ultimaterobotics/surface-emg-eeg/SurfaceEEG_E_V1.3.brd

## EAGLE design SurfaceEEG_E_V1.3.brd (2016-12-27)

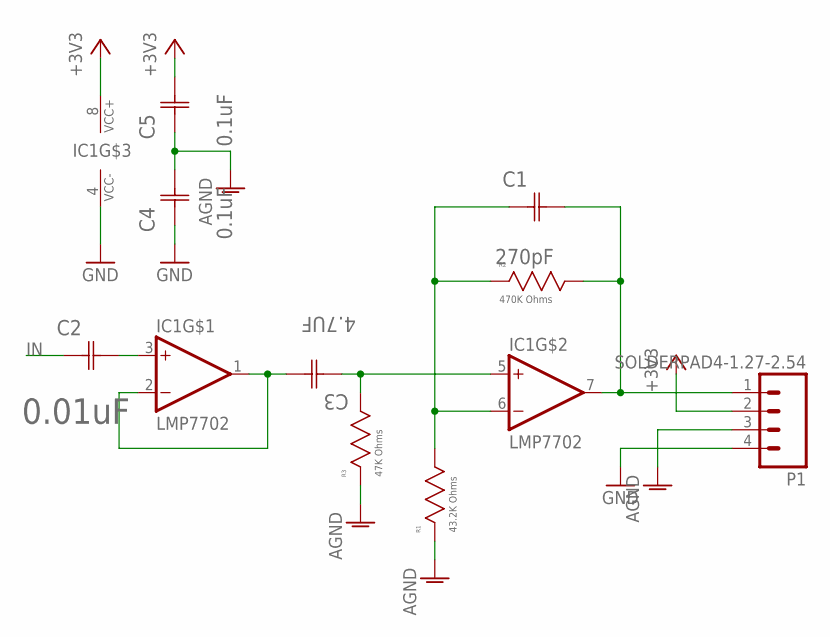
[picture p1: schematic SurfaceEEG_E_V1.3.sch]

Parts:
C1: 270pF; CAPC1608X90N
C2: 0.01uF; CAPC1005X60N
C3: 4.7UF; CAPC1608X90N
C4, C5: 0.1uF; CAPC1005X60N
IC1: LMP7702; VSSOP8
P1: SOLDERPAD4-1.27-2.54; SMD1,27-2,54
R1: 43.2K Ohms; RESC1608X60N
R2: 470K Ohms; RESC1608X60N
R3: 47K Ohms; RESC1608X60N

Connections:
+3V3: C5.1 (C2), IC1.8 (VCC+), P1.2
AGND: C4.1 (C2), C5.2 (C1), P1.3, R1.2 (R2), R3.2 (R2)
GND: C4.2 (C1), IC1.4 (VCC-), P1.4
IN: C2.1 (C1)
unnamed: C2.2 (C2), IC1.3 (IN+)
unnamed: C1.1 (C1), IC1.6 (IN-), R1.1 (R1), R2.2 (R2)
unnamed: C3.1 (C1), IC1.5 (IN+), R3.1 (R1)
unnamed: C1.2 (C2), IC1.7 (OUT), P1.1, R2.1 (R1)
SHIELD: C3.2 (C2), IC1.1 (OUT), IC1.2 (IN-)

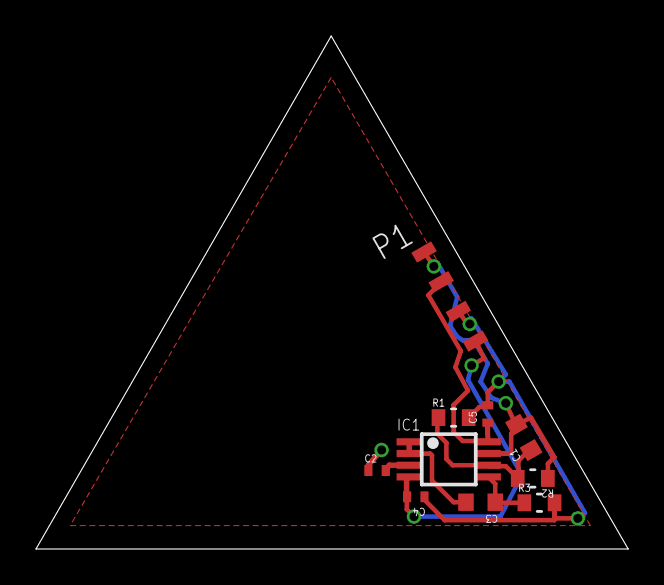
[picture p2: board SurfaceEEG_E_V1.3.brd from above]

Board: 2 copper layers, 32.9 x 28.5 mm, 10 parts (0 on the bottom side), 8 nets.
