ultimaterobotics/surface-emg-eeg/SurfaceEEG_V1.4.brd

## EAGLE design SurfaceEEG_V1.4.brd (2016-12-24)

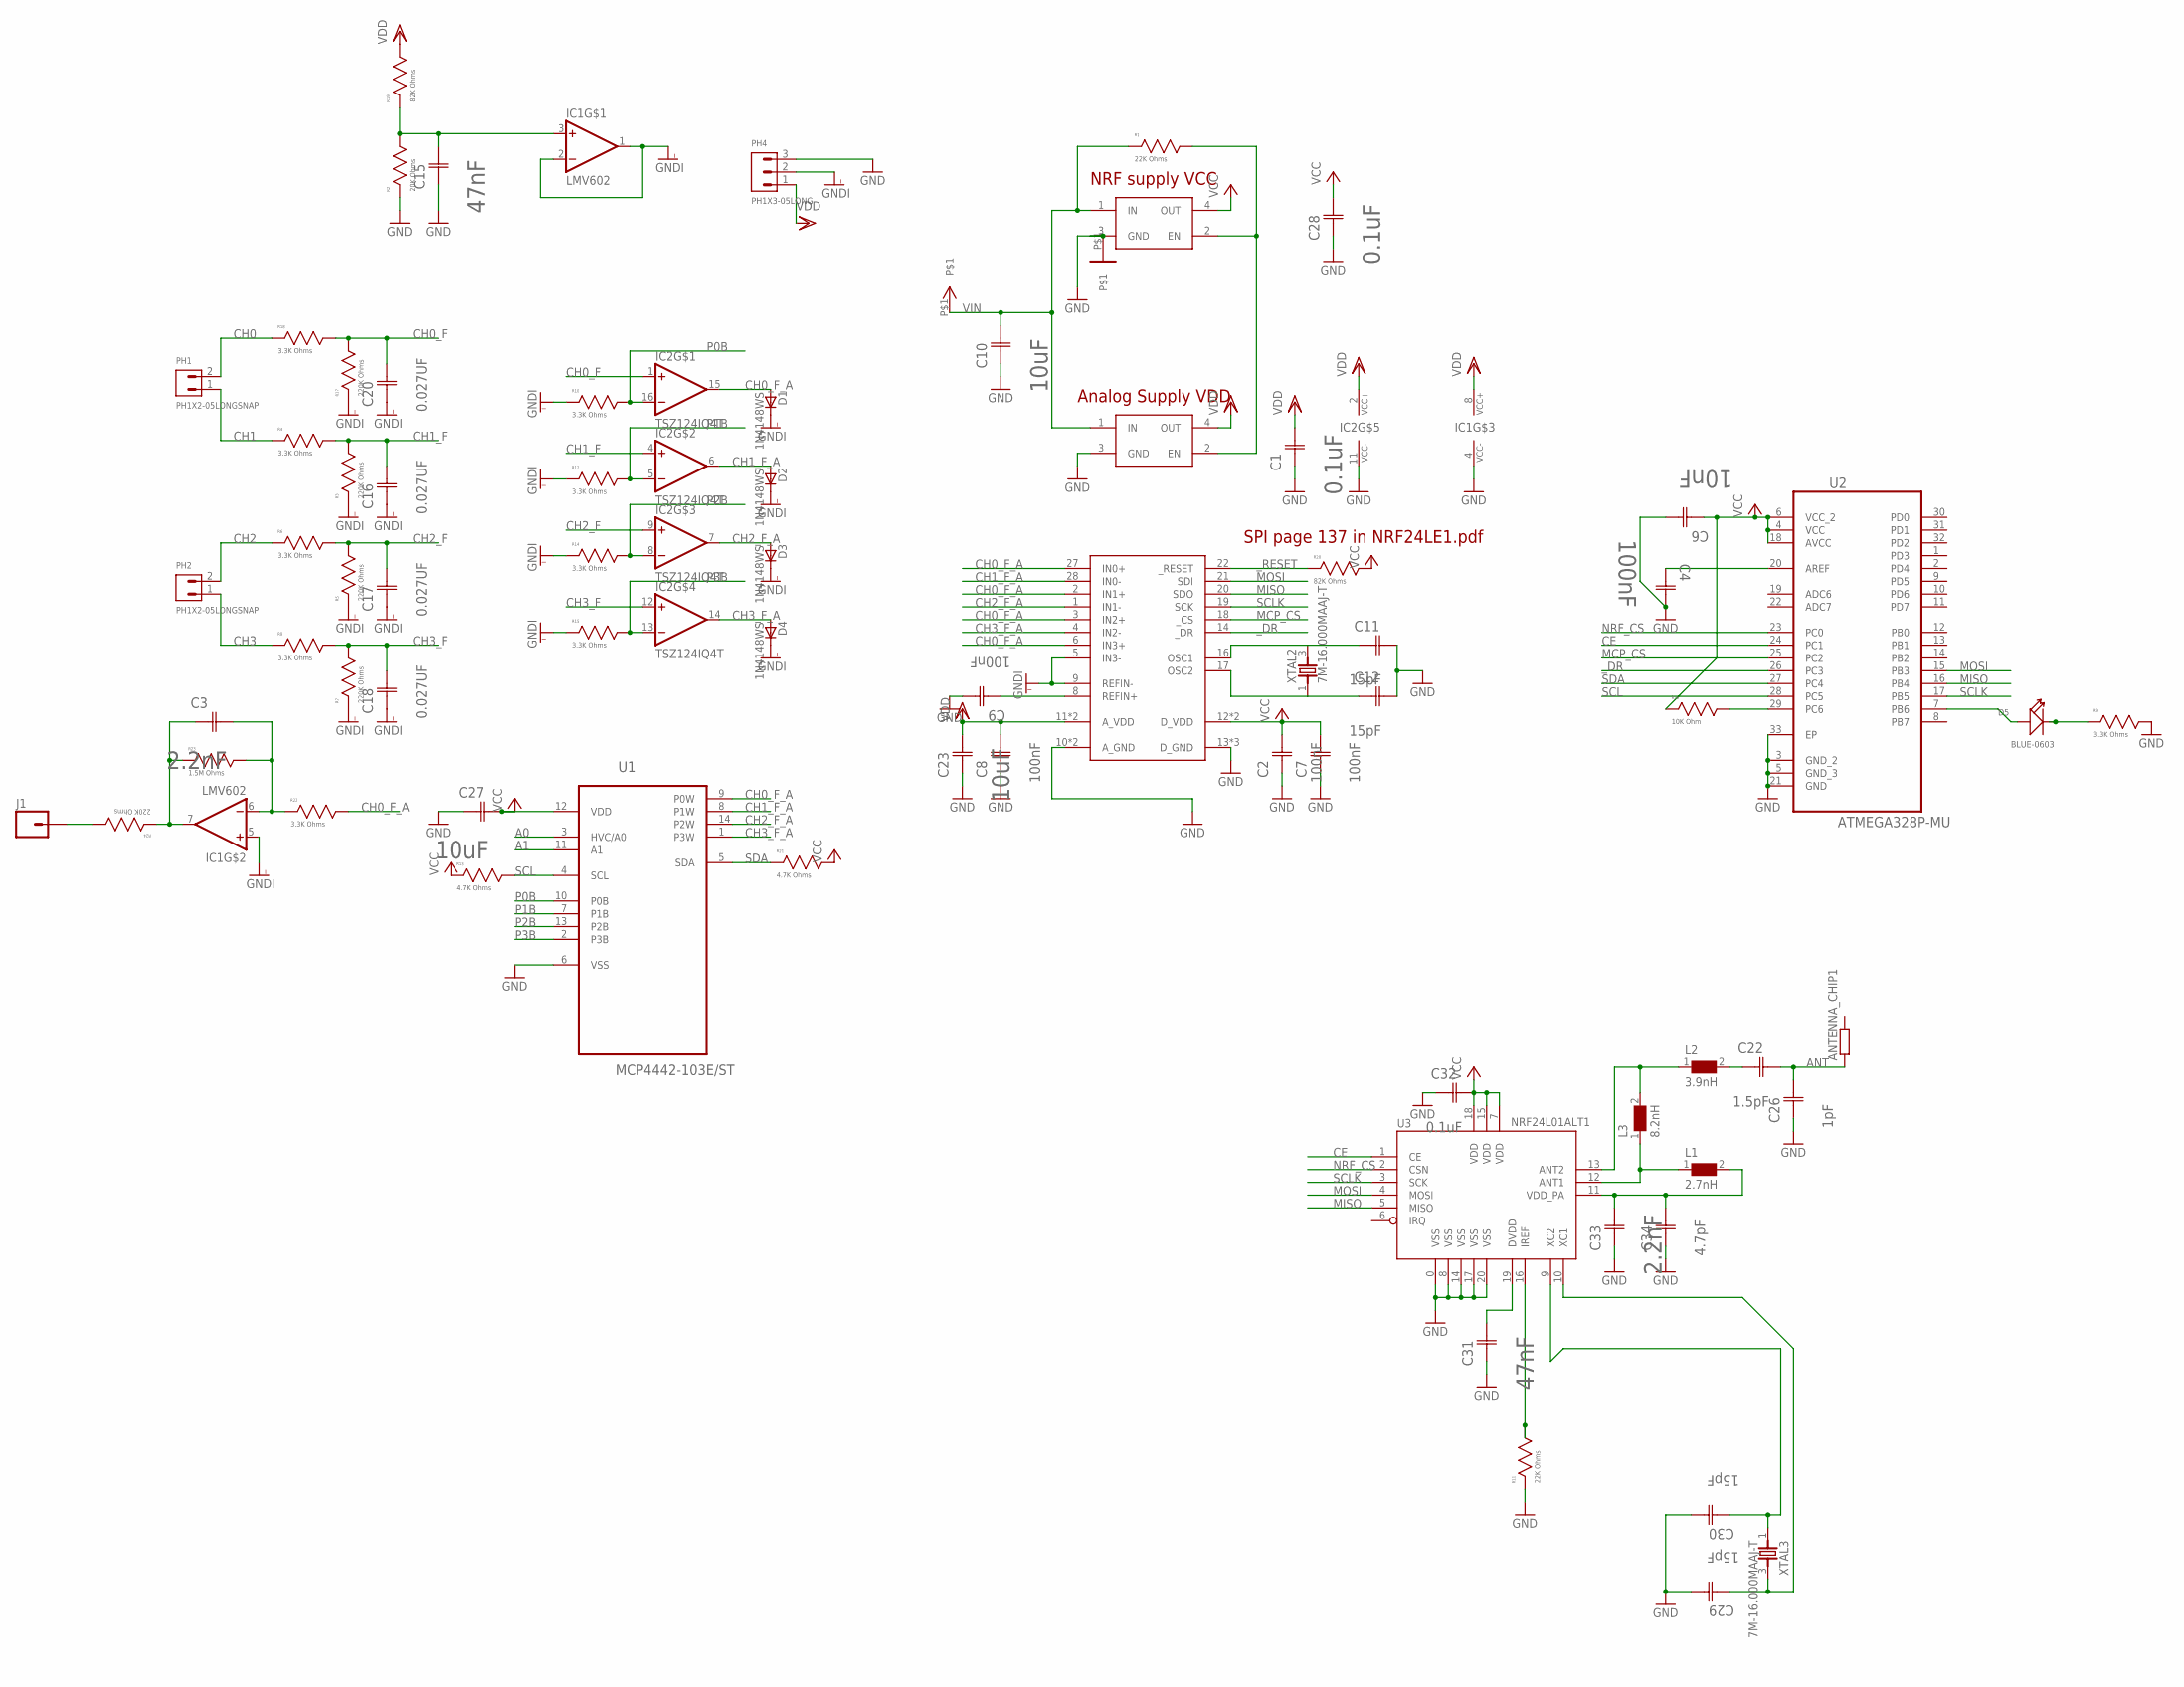
[picture p3: schematic SurfaceEEG_V1.4.sch]

Parts:
ANTENNA_CHIP1: R0805
C1, C28: 0.1uF; CAPC1608X85N
C2, C7, C8, C9: 100nF; CAPC1608X90N
C3, C33: 2.2nF; CAPC1005X60N
C4: 100nF; CAPC1608X85N
C6: 10nF; CAPC1608X85N
C10, C23, C27: 10uF; CAPC1608X85N
C11, C12, C29, C30: 15pF; CAPC1005X60N
C15, C31: 47nF; CAPC1608X85N
C16, C17, C18, C20: 0.027UF; CAPC1608X90N
C22: 1.5pF; CAPC1005X60N
C26: 1pF; CAPC1005X60N
C32: 0.1uF; CAPC1005X60N
C34: 4.7pF; CAPC1005X60N
D1, D2, D3, D4: 1N4148WS; SOD323F
D5: BLUE-0603; LED-0603
IC1: LMV602; VSSOP8
IC2: TSZ124IQ4T; QFN16
J1: M01SMD-4.5X1.5; PAD-1.5X4.5
L1: 2.7nH; WE-KI_0402A
L2: 3.9nH; WE-KI_0402A
L3: 8.2nH; WE-KI_0402A
PH1, PH2: PH1X2-05LONGSNAP; PHLS005-1-2
PH4: PH1X3-05LONG; PHL005-1-3
R1, R11: 22K Ohms; RESC1608X60N
R2: 20K Ohms; RESC1608X60N
R3, R5, R7, R17, R24: 220K Ohms; RESC1608X60N
R4, R6, R8, R9, R10, R12, R14, R15, R18, R22: 3.3K Ohms; RESC1608X60N
R13, R21: 4.7K Ohms; RESC1005X40N
R16: 10K Ohm; RESC1608X60N
R19, R20: 82K Ohms; RESC1608X60N
R23: 1.5M Ohms; RESC1608X60N
U1: MCP4442-103E/ST; SOP65P640X120-14N
U2: ATMEGA328P-MU; QFN50P500X500X100-33N
U3: NRF24L01ALT1; QFN20_ALT1
U$1, U$2: NCP103; UDFN4-1*1
U$3: MCP3912; QFN28
U$4: VCC; VCC-PAD
U$5: GND; GND-PAD
XTAL2, XTAL3: 7M-16.000MAAJ-T; TXC_7M-16.000MAAJ-T

Connections:
A0: U1.3 (HVC/A0)
A1: U1.11 (A1)
ANT: ANTENNA_CHIP1.1, C22.1 (C2), C26.1 (C2)
ANT1: L1.1, L3.1, U3.12 (ANT1)
ANT2: L2.1, L3.2, U3.13 (ANT2)
CE: U2.24 (PC1), U3.1 (CE)
CH0: PH1.2, R18.2 (R2)
CH0_F: C20.2 (C2), IC2.1 (IN+), R17.1 (R1), R18.1 (R1)
CH0_F_A: D1.A, IC2.15 (OUT), R22.1 (R1), U1.9 (P0W), U$3.2 (IN1+), U$3.3 (IN2+), U$3.6 (IN3+), U$3.27 (IN0+)
CH1: PH1.1, R4.2 (R2)
CH1_F: C16.2 (C2), IC2.4 (IN+), R3.1 (R1), R4.1 (R1)
CH1_F_A: D2.A, IC2.6 (OUT), U1.8 (P1W), U$3.28 (IN0-)
CH2: PH2.2, R6.2 (R2)
CH2_F: C17.2 (C2), IC2.9 (IN+), R5.1 (R1), R6.1 (R1)
CH2_F_A: D3.A, IC2.7 (OUT), U1.14 (P2W), U$3.1 (IN1-)
CH3: PH2.1, R8.2 (R2)
CH3_F: C18.2 (C2), IC2.12 (IN+), R7.1 (R1), R8.1 (R1)
CH3_F_A: D4.A, IC2.14 (OUT), U1.1 (P3W), U$3.4 (IN2-)
GND: C1.1 (C1), C2.1 (C1), C4.2 (C2), C6.2 (C2), C7.1 (C1), C8.1 (C1), C9.2 (C2), C10.1 (C1), C11.1 (C2), C12.1 (C2), C15.1 (C1), C23.1 (C1), C26.2 (C1), C27.1 (C1), C28.1 (C1), C29.1 (C2), C30.1 (C2), C31.1 (C1), C32.2 (C1), C33.1 (C1), C34.2 (C1), IC1.4 (VCC-), IC2.11 (VCC-), PH4.3, R2.2 (R2), R9.1 (R1), R11.2 (R2), U1.6 (VSS), U2.3 (GND_2), U2.5 (GND_3), U2.21 (GND), U2.33 (EP), U3.0 (VSS), U3.8 (VSS), U3.14 (VSS), U3.17 (VSS), U3.20 (VSS), U$1.3 (GND), U$2.3 (GND), U$3.10 (A_GND), U$3.13 (D_GND), U$3.15 (D_GND), U$3.23 (D_GND), U$3.26 (A_GND), U$5.P$1
GNDI: C16.1 (C1), C17.1 (C1), C18.1 (C1), C20.1 (C1), D1.C, D2.C, D3.C, D4.C, IC1.1 (OUT), IC1.2 (IN-), IC1.5 (IN+), PH4.2, R3.2 (R2), R5.2 (R2), R7.2 (R2), R10.2 (R2), R12.2 (R2), R14.2 (R2), R15.2 (R2), R17.2 (R2), U$3.5 (IN3-), U$3.9 (REFIN-)
MCP_CS: U2.25 (PC2), U$3.18 (_CS)
MISO: U2.16 (PB4), U3.5 (MISO), U$3.20 (SDO)
MOSI: U2.15 (PB3), U3.4 (MOSI), U$3.21 (SDI)
unnamed: D5.+, U2.7 (PB6)
unnamed: D5.-, R9.2 (R2)
unnamed: C3.2 (C2), IC1.6 (IN-), R22.2 (R2), R23.1 (R1)
unnamed: R1.1 (R1), U$1.2 (EN), U$2.2 (EN)
unnamed: C3.1 (C1), IC1.7 (OUT), R23.2 (R2), R24.2 (R2)
unnamed: C4.1 (C1), U2.20 (AREF)
unnamed: C30.2 (C1), U3.9 (XC2), XTAL3.1
unnamed: C29.2 (C1), U3.10 (XC1), XTAL3.3
unnamed: J1.P$1, R24.1 (R1)
unnamed: C9.1 (C1), U$3.8 (REFIN+)
unnamed: C22.2 (C1), L2.2
unnamed: C11.2 (C1), U$3.16 (OSC1), XTAL2.3
unnamed: C12.2 (C1), U$3.17 (OSC2), XTAL2.1
unnamed: C33.2 (C2), C34.1 (C2), L1.2, U3.11 (VDD_PA)
unnamed: C15.2 (C2), IC1.3 (IN+), R2.1 (R1), R19.2 (R2)
unnamed: R11.1 (R1), U3.16 (IREF)
unnamed: C31.2 (C2), U3.19 (DVDD)
NRF_CS: U2.23 (PC0), U3.2 (CSN)
P0B: IC2.16 (IN-), R10.1 (R1), U1.10 (P0B)
P1B: IC2.5 (IN-), R12.1 (R1), U1.7 (P1B)
P2B: IC2.8 (IN-), R14.1 (R1), U1.13 (P2B)
P3B: IC2.13 (IN-), R15.1 (R1), U1.2 (P3B)
RESET: R16.1 (R1), U2.29 (PC6)
SCL: R13.1 (R1), U1.4 (SCL), U2.28 (PC5)
SCLK: U2.17 (PB5), U3.3 (SCK), U$3.19 (SCK)
SDA: R21.2 (R2), U1.5 (SDA), U2.27 (PC4)
VCC: C2.2 (C2), C6.1 (C1), C7.2 (C2), C27.2 (C2), C28.2 (C2), C32.1 (C2), R13.2 (R2), R16.2 (R2), R20.1 (R1), R21.1 (R1), U1.12 (VDD), U2.4 (VCC), U2.6 (VCC_2), U2.18 (AVCC), U3.7 (VDD), U3.15 (VDD), U3.18 (VDD), U$1.4 (OUT), U$3.12 (D_VDD), U$3.24 (D_VDD)
VDD: C1.2 (C2), C8.2 (C2), C23.2 (C2), IC1.8 (VCC+), IC2.2 (VCC+), PH4.1, R19.1 (R1), U$2.4 (OUT), U$3.11 (A_VDD), U$3.25 (A_VDD)
VIN: C10.2 (C2), R1.2 (R2), U$1.1 (IN), U$2.1 (IN), U$4.P$1
_DR: U2.26 (PC3), U$3.14 (_DR)
_RESET: R20.2 (R2), U$3.22 (_RESET)

Notes on the sheet:
SPI page 137 in NRF24LE1.pdf
NRF supply VCC
Analog Supply VDD

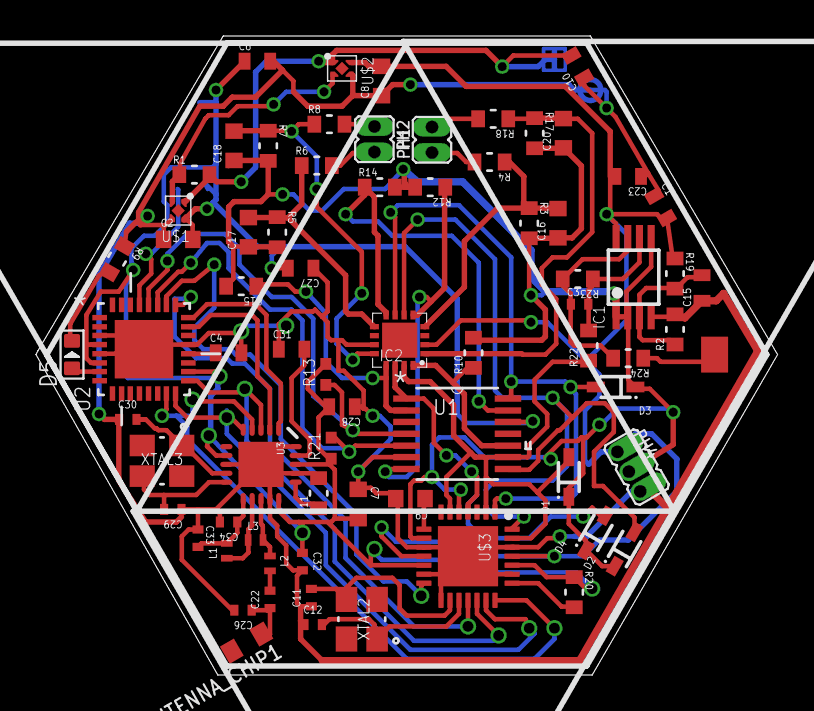
[picture p4: board SurfaceEEG_V1.4.brd from above]

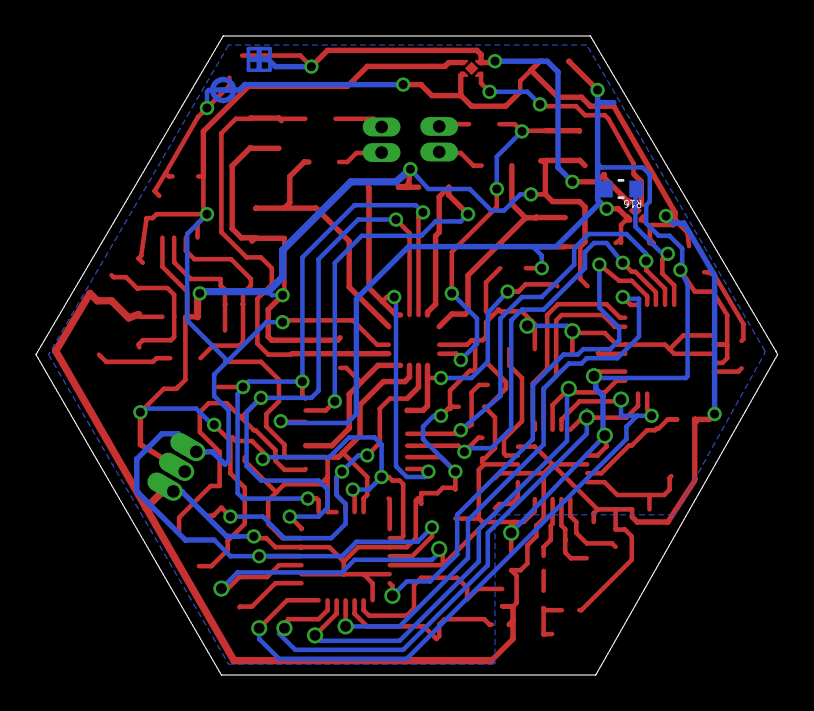
[picture p5: board SurfaceEEG_V1.4.brd from below]

Board: 2 copper layers, 41.2 x 35.5 mm, 76 parts (3 on the bottom side), 52 nets.
