ultimaterobotics/surface-emg-eeg/SurfaceEEG_Central_V1.0.brd

## EAGLE design SurfaceEEG_Central_V1.0.brd (2016-12-12)

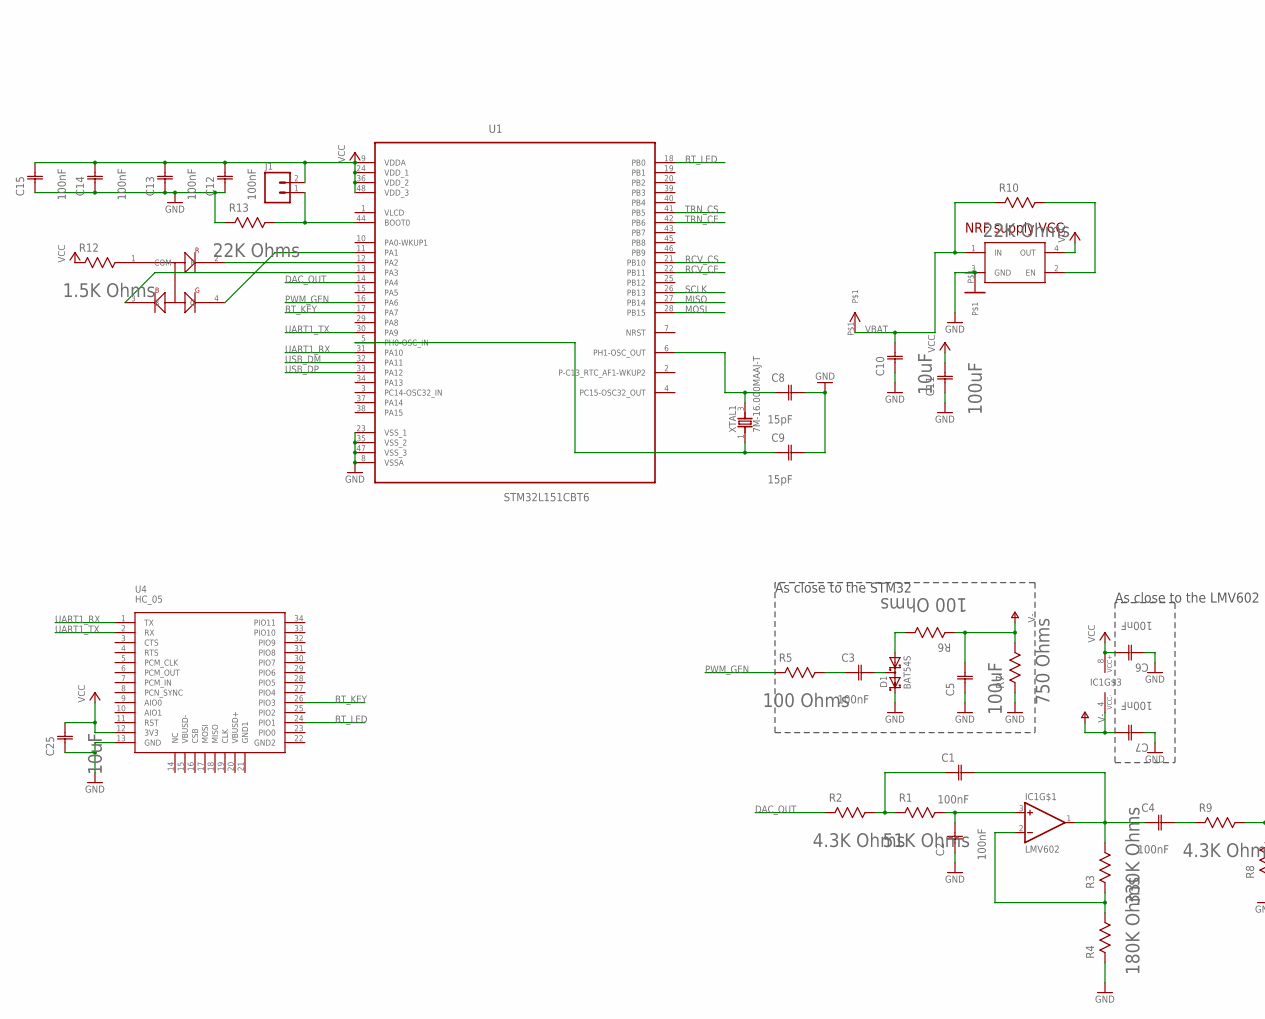
[picture p6: schematic SurfaceEEG_Central_V1.0.sch, part in row 1, column 1]

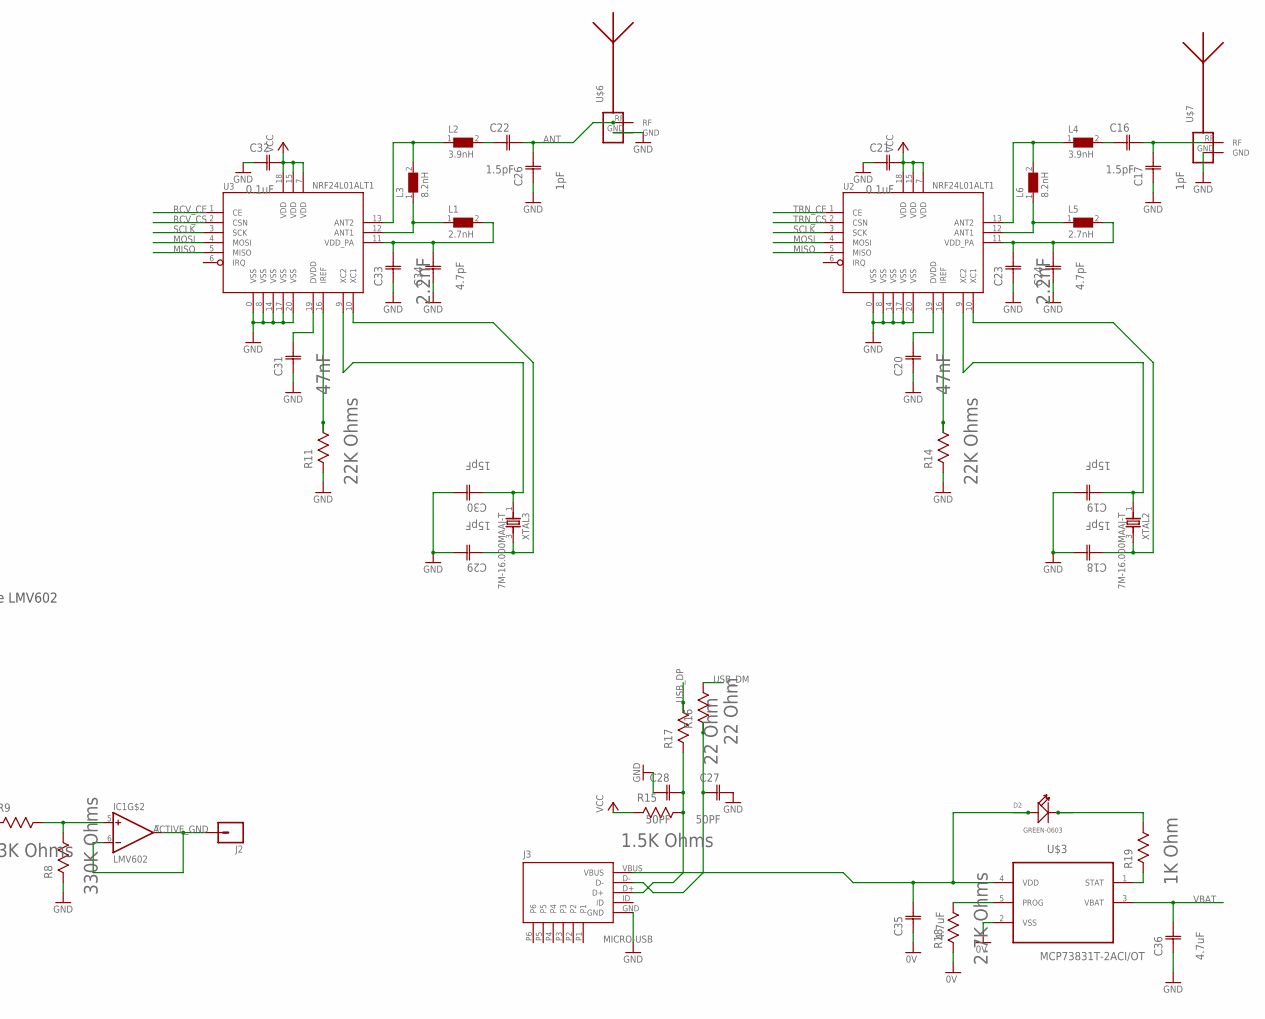
[picture p7: schematic SurfaceEEG_Central_V1.0.sch, part in row 1, column 2]

Parts:
C1, C2, C3, C4, C6, C7, C12, C13, C14, C15: 100nF; CAPC1608X90N
C5, C11: 100uF; CAPC3216X180N
C8, C9, C18, C19, C29, C30: 15pF; CAPC1005X60N
C10, C25: 10uF; CAPC1608X85N
C16, C22: 1.5pF; CAPC1005X60N
C17, C26: 1pF; CAPC1005X60N
C20, C31: 47nF; CAPC1608X85N
C21, C32: 0.1uF; CAPC1005X60N
C23, C33: 2.2nF; CAPC1005X60N
C24, C34: 4.7pF; CAPC1005X60N
C27, C28: 50PF; CAPC1608X90N
C35, C36: 4.7uF; CAPC2013X152N
D1: BAT54S; SOT23
D2: GREEN-0603; LED-0603
IC1: LMV602; VSSOP8
J1: M02PTH; 1X02
J2: M01SMD-4.5X1.5; PAD-1.5X4.5
J3: MICRO-USB; MICRO_USB
L1, L5: 2.7nH; WE-KI_0402A
L2, L4: 3.9nH; WE-KI_0402A
L3, L6: 8.2nH; WE-KI_0402A
R1: 51K Ohms; RESC1608X60N
R2, R9: 4.3K Ohms; RESC1608X60N
R3, R8: 330K Ohms; RESC1608X60N
R4: 180K Ohms; RESC1608X60N
R5, R6: 100 Ohms; RESC1608X60N
R7: 750 Ohms; RESC1608X60N
R10, R11, R13, R14: 22K Ohms; RESC1608X60N
R12, R15: 1.5K Ohms; RESC1608X60N
R16, R17: 22 Ohm; RESC1608X60N
R18: 2.7K Ohms; RESC1608X60N
R19: 1K Ohm; RESC1608X60N
U1: STM32L151CBT6; QFP50P900X900X160-48N
U2, U3: NRF24L01ALT1; QFN20_ALT1
U4: HC_05; BLUETOOTH_SMD
U$1: NCP103; UDFN4-1*1
U$2: RGB-LED; 1615-RGB-LED
U$3: MCP73831T-2ACI/OT; SOT95P280X145-5N
U$4: VCC; VCC-PAD
U$5: GND; GND-PAD
U$6: ANTENNA_1LEFT; SWRA117D_LEFT
U$7: ANTENNA_1RIGHT; SWRA117D_RIGHT
XTAL1, XTAL2, XTAL3: 7M-16.000MAAJ-T; TXC_7M-16.000MAAJ-T

Connections:
0V: C35.1 (C1), R18.2 (R2), U$3.2 (VSS)
ACTIVE_GND: IC1.6 (IN-), IC1.7 (OUT), J2.P$1
ANT: C22.1 (C2), C26.1 (C2), U$6.RF
ANT1: L1.1, L3.1, U3.12 (ANT1)
ANT2: L2.1, L3.2, U3.13 (ANT2)
ANT3: L4.1, L6.2, U2.13 (ANT2)
ANT4: L5.1, L6.1, U2.12 (ANT1)
BT_KEY: U1.17 (PA7), U4.26 (PIO3)
BT_LED: U1.18 (PB0), U4.24 (PIO1)
DAC_OUT: R2.2 (R2), U1.14 (PA4)
GND: C2.1 (C1), C5.1 (C1), C6.1 (C1), C7.1 (C1), C8.1 (C2), C9.1 (C2), C10.1 (C1), C11.1 (C1), C12.1 (C1), C13.1 (C1), C14.1 (C1), C15.1 (C1), C17.2 (C1), C18.1 (C2), C19.1 (C2), C20.1 (C1), C21.2 (C1), C23.1 (C1), C24.2 (C1), C25.1 (C1), C26.2 (C1), C27.2 (C2), C28.1 (C1), C29.1 (C2), C30.1 (C2), C31.1 (C1), C32.2 (C1), C33.1 (C1), C34.2 (C1), C36.1 (C1), D1.2 (C2), J3.GND, R4.2 (R2), R7.2 (R2), R8.2 (R2), R11.2 (R2), R13.2 (R2), R14.2 (R2), U1.8 (VSSA), U1.23 (VSS_1), U1.35 (VSS_2), U1.47 (VSS_3), U2.0 (VSS), U2.8 (VSS), U2.14 (VSS), U2.17 (VSS), U2.20 (VSS), U3.0 (VSS), U3.8 (VSS), U3.14 (VSS), U3.17 (VSS), U3.20 (VSS), U4.13 (GND), U$1.3 (GND), U$5.P$1, U$6.GND, U$7.GND
MISO: U1.27 (PB14), U2.5 (MISO), U3.5 (MISO)
MOSI: U1.28 (PB15), U2.4 (MOSI), U3.4 (MOSI)
unnamed: C1.1 (C1), R1.2 (R2), R2.1 (R1)
unnamed: IC1.2 (IN-), R3.2 (R2), R4.1 (R1)
unnamed: C1.2 (C2), C4.1 (C1), IC1.1 (OUT), R3.1 (R1)
unnamed: C2.2 (C2), IC1.3 (IN+), R1.1 (R1)
unnamed: IC1.5 (IN+), R8.1 (R1), R9.1 (R1)
unnamed: C4.2 (C2), R9.2 (R2)
unnamed: C3.1 (C1), R5.1 (R1)
unnamed: C3.2 (C2), D1.3 (C1A2)
unnamed: D1.1 (A1), R6.1 (R1)
unnamed: C29.2 (C1), U3.10 (XC1), XTAL3.3
unnamed: R10.1 (R1), U$1.2 (EN)
unnamed: C30.2 (C1), U3.9 (XC2), XTAL3.1
unnamed: C22.2 (C1), L2.2
unnamed: C8.2 (C1), U1.6 (PH1-OSC_OUT), XTAL1.3
unnamed: C9.2 (C1), U1.5 (PH0-OSC_IN), XTAL1.1
unnamed: C33.2 (C2), C34.1 (C2), L1.2, U3.11 (VDD_PA)
unnamed: U1.12 (PA2), U$2.2 (R)
unnamed: U1.13 (PA3), U$2.3 (B)
unnamed: R11.1 (R1), U3.16 (IREF)
unnamed: C31.2 (C2), U3.19 (DVDD)
unnamed: U1.11 (PA1), U$2.4 (G)
unnamed: R12.1 (R1), U$2.1 (COM)
unnamed: J1.1, R13.1 (R1), U1.44 (BOOT0)
unnamed: C18.2 (C1), U2.10 (XC1), XTAL2.3
unnamed: C23.2 (C2), C24.1 (C2), L5.2, U2.11 (VDD_PA)
unnamed: R14.1 (R1), U2.16 (IREF)
unnamed: C20.2 (C2), U2.19 (DVDD)
unnamed: C16.2 (C1), L4.2
unnamed: C19.2 (C1), U2.9 (XC2), XTAL2.1
unnamed: C16.1 (C2), C17.1 (C2), U$7.RF
unnamed: C35.2 (C2), D2.+, J3.VBUS, U$3.4 (VDD)
unnamed: C28.2 (C2), J3.D+, R15.1 (R1), R17.2 (R2)
unnamed: C27.1 (C1), J3.D-, R16.2 (R2)
unnamed: R18.1 (R1), U$3.5 (PROG)
unnamed: D2.-, R19.1 (R1)
unnamed: R19.2 (R2), U$3.1 (STAT)
PWM_GEN: R5.2 (R2), U1.16 (PA6)
RCV_CE: U1.22 (PB11), U3.1 (CE)
RCV_CS: U1.21 (PB10), U3.2 (CSN)
SCLK: U1.26 (PB13), U2.3 (SCK), U3.3 (SCK)
TRN_CE: U1.42 (PB6), U2.1 (CE)
TRN_CS: U1.41 (PB5), U2.2 (CSN)
UART1_RX: U1.31 (PA10), U4.1 (TX)
UART1_TX: U1.30 (PA9), U4.2 (RX)
USB_DM: R16.1 (R1), U1.32 (PA11)
USB_DP: R17.1 (R1), U1.33 (PA12)
V-: C5.2 (C2), C7.2 (C2), IC1.4 (VCC-), R6.2 (R2), R7.1 (R1)
VBAT: C10.2 (C2), C36.2 (C2), R10.2 (R2), U$1.1 (IN), U$3.3 (VBAT), U$4.P$1
VCC: C6.2 (C2), C11.2 (C2), C12.2 (C2), C13.2 (C2), C14.2 (C2), C15.2 (C2), C21.1 (C2), C25.2 (C2), C32.1 (C2), IC1.8 (VCC+), J1.2, R12.2 (R2), R15.2 (R2), U1.9 (VDDA), U1.24 (VDD_1), U1.36 (VDD_2), U1.48 (VDD_3), U2.7 (VDD), U2.15 (VDD), U2.18 (VDD), U3.7 (VDD), U3.15 (VDD), U3.18 (VDD), U4.12 (3V3), U$1.4 (OUT)
VLCD: U1.1 (VLCD)

Notes on the sheet:
As close to the STM32
As close to the LMV602
NRF supply VCC

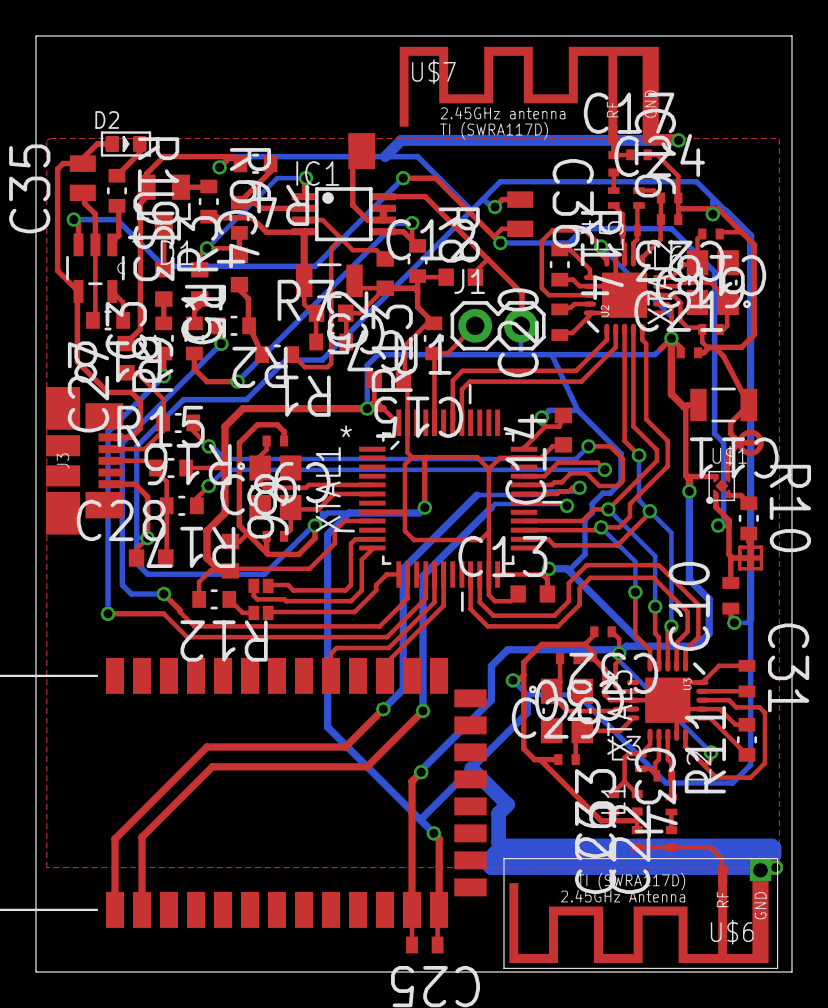
[picture p8: board SurfaceEEG_Central_V1.0.brd from above]

Board: 2 copper layers, 42.0 x 52.0 mm, 81 parts (0 on the bottom side), 62 nets.
