ultimaterobotics/surface-emg-eeg/Testing_LAB_EMG_V1.2.brd

## EAGLE design Testing_LAB_EMG_V1.2.brd (2016-12-12)

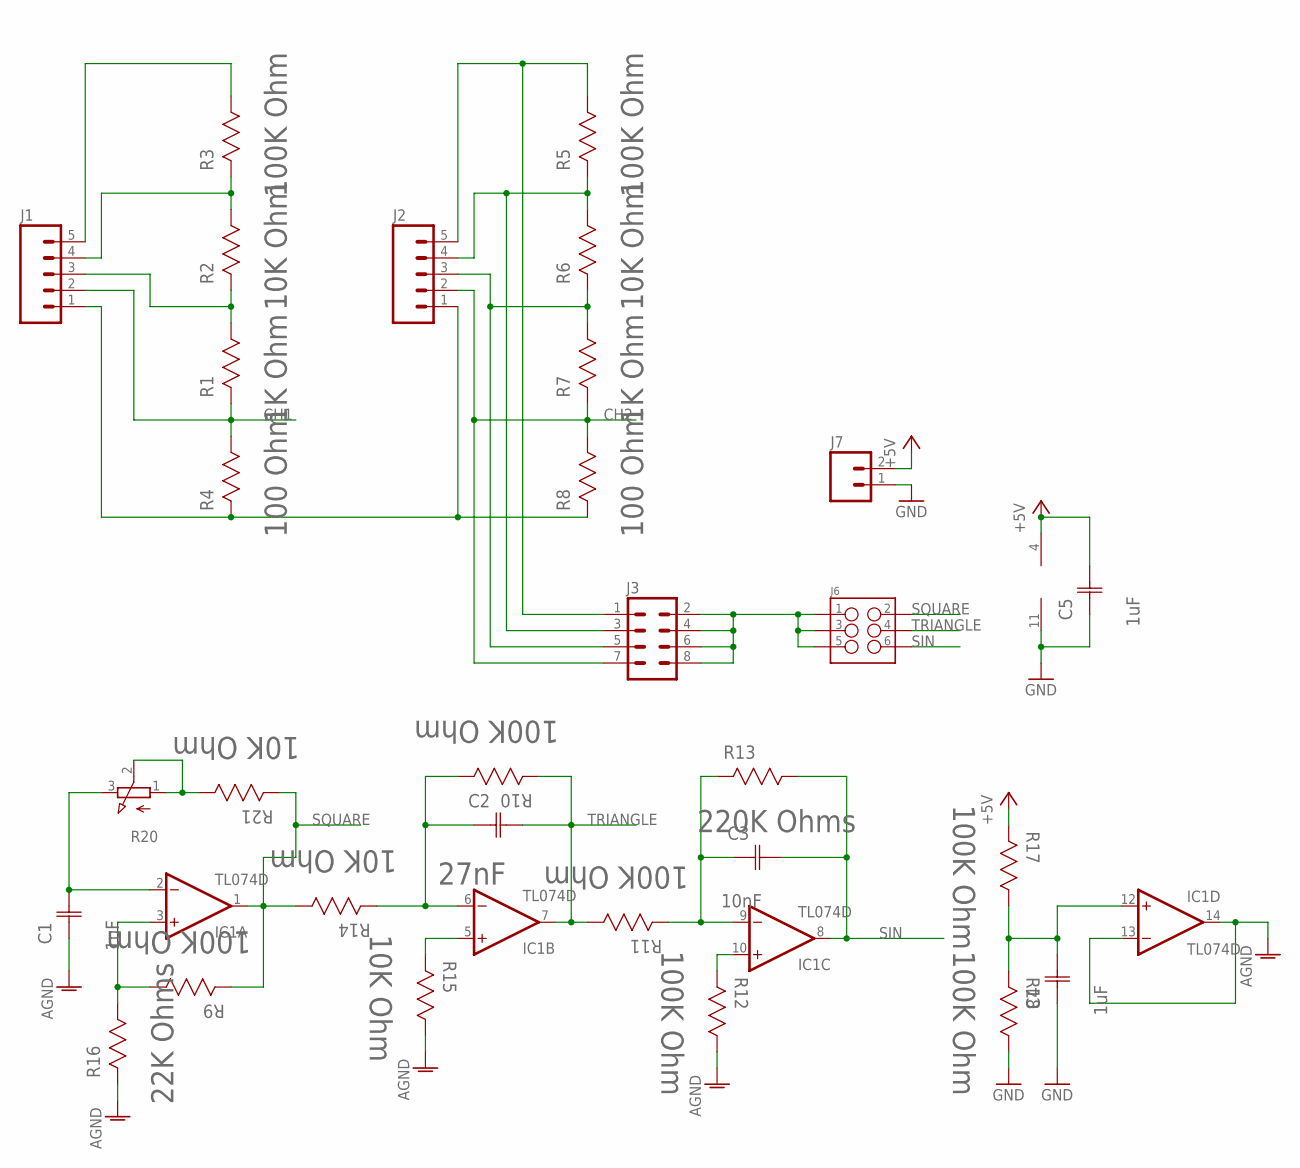
[picture p9: schematic Testing_LAB_EMG_V1.2.sch]

Parts:
C1, C4, C5: 1uF; CAPC1608X94N
C2: 27nF; CAPC1005X60N
C3: 10nF; CAPC1608X90N
IC1: TL074D; SO14
J1, J2: M05PTH; 1X05
J3: M04X2; 2X4
J6: M03X2NO_SILK; 2X3-NS
J7: M02PTH; 1X02
R1, R7: 1K Ohm; RESC1608X60N
R2, R6, R14, R15, R21: 10K Ohm; RESC1608X60N
R3, R5, R9, R10, R11, R12, R17, R18: 100K Ohm; RESC1608X60N
R4, R8: 100 Ohm; RESC1608X60N
R13: 220K Ohms; RESC1608X60N
R16: 22K Ohms; RESC1608X60N
R20: 3RP/1610N

Connections:
+5V: C5.2 (C2), IC1.4 (V+), J7.2, R17.2 (R2)
AGND: C1.1 (C1), IC1.13 (-IN), IC1.14 (OUT), R12.1 (R1), R15.1 (R1), R16.2 (R2)
CH1: J1.2, R1.2 (R2), R4.1 (R1)
CH2: J2.2, J3.7, R7.2 (R2), R8.1 (R1)
GND: C4.1 (C1), C5.1 (C1), IC1.11 (V-), J7.1, R18.1 (R1)
unnamed: J1.5, R3.1 (R1)
unnamed: J1.4, R2.1 (R1), R3.2 (R2)
unnamed: J1.3, R1.1 (R1), R2.2 (R2)
unnamed: J2.4, J3.3, R5.2 (R2), R6.1 (R1)
unnamed: J1.1, J2.1, R4.2 (R2), R8.2 (R2)
unnamed: J2.3, J3.5, R6.2 (R2), R7.1 (R1)
unnamed: J2.5, J3.1, R5.1 (R1)
unnamed: C4.2 (C2), IC1.12 (+IN), R17.1 (R1), R18.2 (R2)
unnamed: R20.1 (A), R20.2 (S), R21.1 (R1)
unnamed: J3.2, J3.4, J3.6, J3.8, J6.1, J6.3, J6.5
unnamed: IC1.3 (+IN), R9.1 (R1), R16.1 (R1)
unnamed: C1.2 (C2), IC1.2 (-IN), R20.3 (E)
unnamed: IC1.5 (+IN), R15.2 (R2)
unnamed: C2.1 (C1), IC1.6 (-IN), R10.1 (R1), R14.2 (R2)
unnamed: IC1.10 (+IN), R12.2 (R2)
unnamed: C3.1 (C1), IC1.9 (-IN), R11.2 (R2), R13.2 (R2)
SIN: C3.2 (C2), IC1.8 (OUT), J6.6, R13.1 (R1)
SQUARE: IC1.1 (OUT), J6.2, R9.2 (R2), R14.1 (R1), R21.2 (R2)
TRIANGLE: C2.2 (C2), IC1.7 (OUT), J6.4, R10.2 (R2), R11.1 (R1)

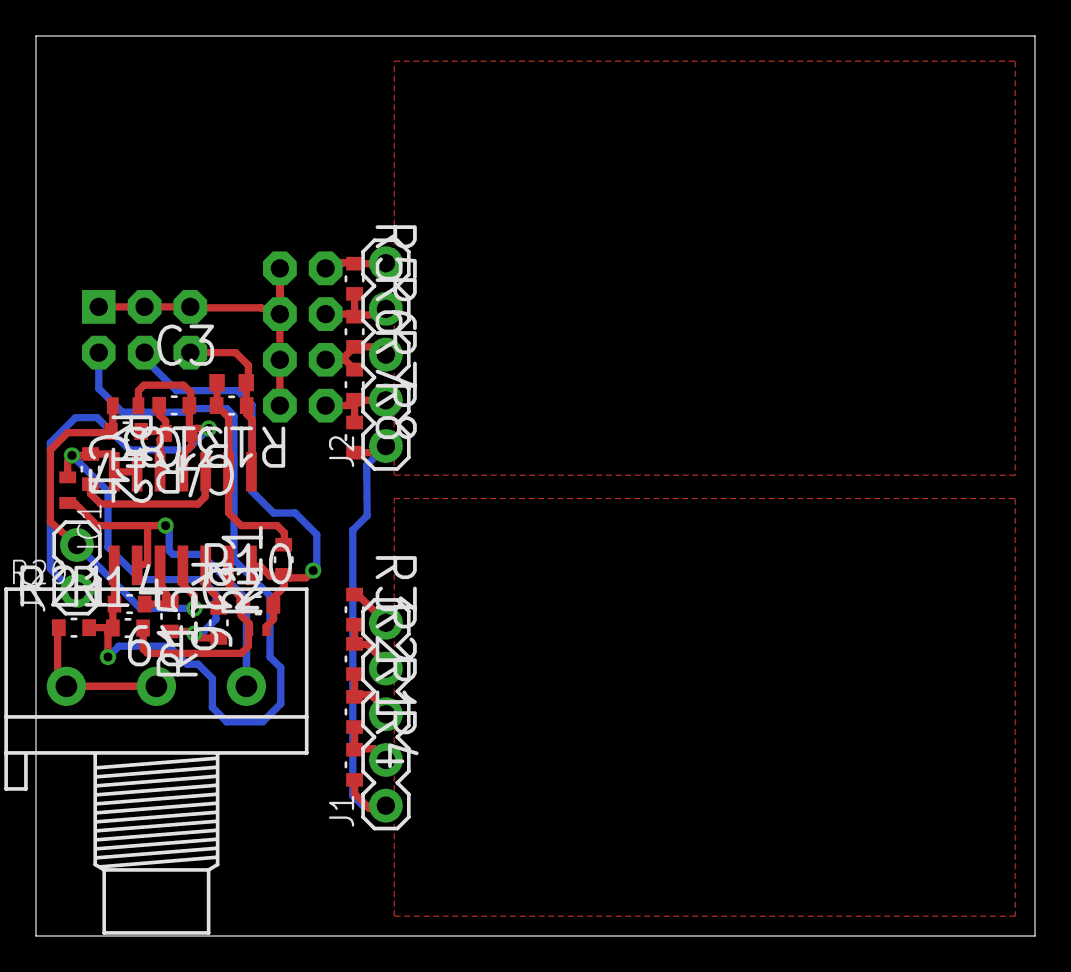
[picture p10: board Testing_LAB_EMG_V1.2.brd from above]

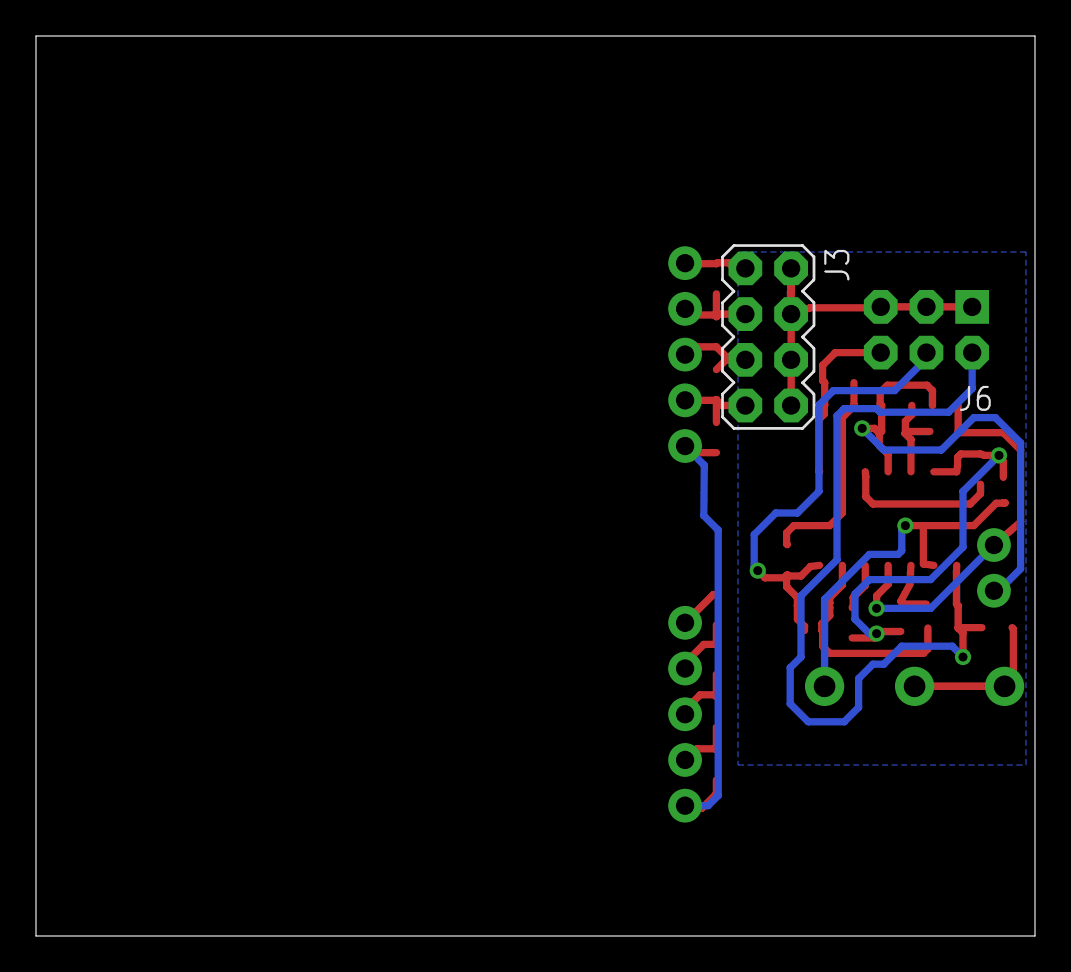
[picture p11: board Testing_LAB_EMG_V1.2.brd from below]

Board: 2 copper layers, 55.5 x 50.0 mm, 31 parts (2 on the bottom side), 24 nets.
