ultimaterobotics/surface-emg-eeg/(commit log)

2016-12-02 Added current version of EMG module
    [SurfaceEEG_V1.2.sch]
2016-12-02 Replaced components with ones from our libraries
    [SurfaceEEG_V1.2.sch]
2016-12-02 Added RF antenna schematics
    [SurfaceEEG_V1.2.sch]
2016-12-02 Add crystal 16 MHz
    Add crystal 16 MHz for NRF24LE1
    [SurfaceEEG_V1.2.sch]
2016-12-05 Created almost finished board, fixed schematics
    Schematics was switched for 3 differential + 1 relative to ground measurements, board was designed accordingly
    [SurfaceEEG_V1.2.brd, SurfaceEEG_V1.2.sch]
2016-12-05 Add active electrodes V1.1
    I think that this connector will be huge.
    [SurfaceEEG_E_V1.1.brd, SurfaceEEG_E_V1.1.sch]
2016-12-05 Finished PCB and updated schematics
    Added headers for sensor board connection and placed/routed remaining caps, optimized everything
    [SurfaceEEG_V1.2.brd, SurfaceEEG_V1.2.sch]
2016-12-05 Changed RF chip to 24-pin version
    We realized too late that our actual chips were in 24-pin packages...
    [SurfaceEEG_V1.3.brd, SurfaceEEG_V1.3.sch]
2016-12-05 Add high pass filter to active electrode
    Add high pass filter and trace PCB V1.2
    [SurfaceEEG_E_V1.2.brd, SurfaceEEG_E_V1.2.sch]
2016-12-07 Added SurfaceEEG HUB
    Added schematic and board for SurfaceEEG_HUB_V1.0
    [SurfaceEEG_Hub_V1.0.brd, SurfaceEEG_Hub_V1.0.sch, SurfaceEEG_V1.3.brd]
2016-12-07 Started version 1.4 with atmega328
    [SurfaceEEG_V1.3.brd, SurfaceEEG_V1.4.brd, SurfaceEEG_V1.4.sch]
2016-12-07 Fixed hub module according to DRC
    [SurfaceEEG_Hub_V1.0.brd, SurfaceEEG_Hub_V1.0.sch]
2016-12-07 Fixed unrouted wire
    [SurfaceEEG_Hub_V1.0.brd]
2016-12-07 Added new solder pad
    Added new SOLDERPAD4-1.27-2.54 to SurfaceEEG_Hub
    [SurfaceEEG_E_V1.3.brd, SurfaceEEG_E_V1.3.sch]
2016-12-07 Updated SurfaceEEG_E
    Updated SurfaceEEG_E to V1.3. Replaced solder pads. Improved layout and
    checked DRC.
    [SurfaceEEG_E_V1.3.brd, SurfaceEEG_E_V1.3.sch]
2016-12-08 Version 1.4 with atmega328 and hrf24L01 ready
    [SurfaceEEG_V1.4.brd, SurfaceEEG_V1.4.sch]
2016-12-08 Updated all boards in order to comply with DRC
    [SurfaceEEG_E_V1.3.brd, SurfaceEEG_Hub_V1.0.brd, SurfaceEEG_V1.4.brd, SurfaceEEG_V1.4.sch]
2016-12-11 Added active ground
    Ku = 50 dB on 50 Hz
    A low-pass filter = -6 dB/octave, 1 kHz = 26 dB, 22 kHz = 0 dB
    [SurfaceEEG_V1.4.brd, SurfaceEEG_V1.4.sch]
2016-12-11 added led
    [SurfaceEEG_V1.4.brd, SurfaceEEG_V1.4.sch]
2016-12-11 Module active ground completed
    [SurfaceEEG_V1.4.brd, SurfaceEEG_V1.4.sch]
2016-12-11 Added SurfaceEEG_Central and active ground schematic
    V1.0
    - Low-pass filter II-order, Fs = 100 Hz, Ku = 2.83;
    - High-pass filter I-order, Fs = 5 Hz, Ku = 1;
    - Voltage inverter: 50 kHz, Out = -1.5 V, 200 uV noize p-p, set up time
    300 ms;
    [SurfaceEEG_Central_V1.0.sch]
2016-12-12 Central unit completed, testing module added
    [SurfaceEEG_Central_V1.0.brd, SurfaceEEG_Central_V1.0.sch, Testing_LAB_EMG_V1.2.brd, Testing_LAB_EMG_V1.2.sch]
2016-12-24 Board changed after library changes
    After making fonts smaller, the board have changed
    [SurfaceEEG_V1.4.brd, SurfaceEEG_V1.4.sch]
2016-12-27 Boards changed after changing fonts
    That's it.
    [SurfaceEEG_E_V1.3.brd, SurfaceEEG_E_V1.3.sch, SurfaceEEG_Hub_V1.0.brd, SurfaceEEG_Hub_V1.0.sch]
