ultimaterobotics/surface-emg-eeg/(notices)

Notices in the files:
parts and their libraries:
SparkFun-Connectors: Licensing: Creative Commons ShareAlike 4.0 International - https://creativecommons.org/licenses/by-sa/4.0
ELL-i-Passives: Originally copied from SparkFun-Passives.lbr, under SparkFun Creative Commons license.
